vitoska26/agrotech_project/Extras/Project Sketch.pdf

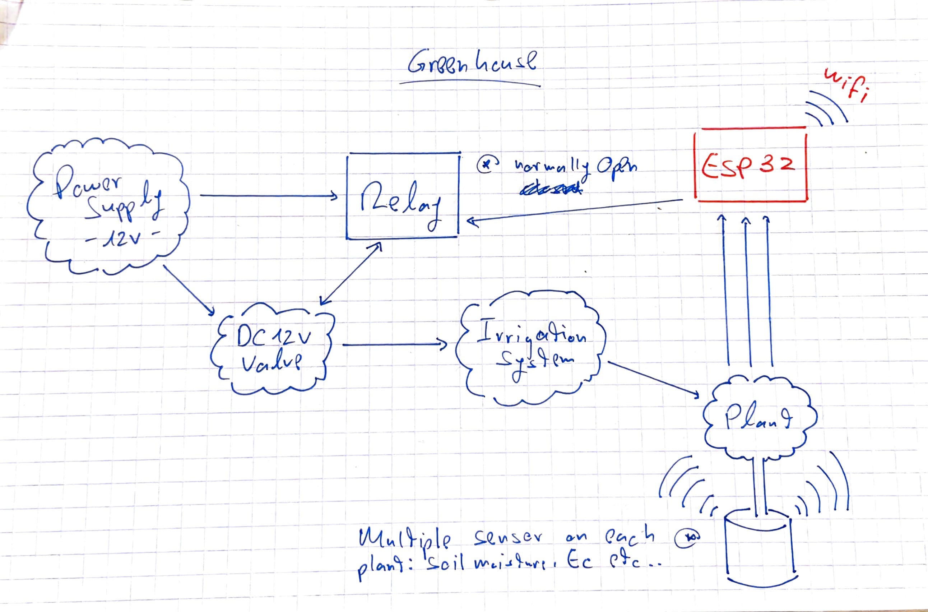
[picture p4: page 1]
