vitoska26/agrotech_project/Images/#1 Pepper.jpeg

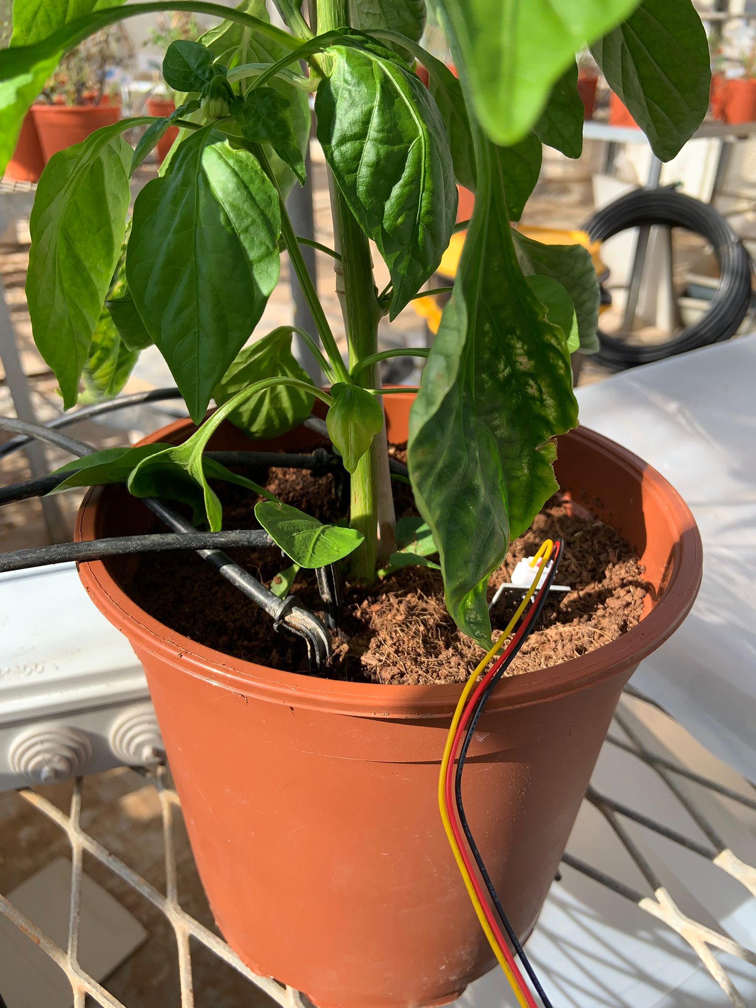
Images/#1 Pepper.jpeg
