vitoska26/agrotech_project/Images/#2 Pepper.jpeg

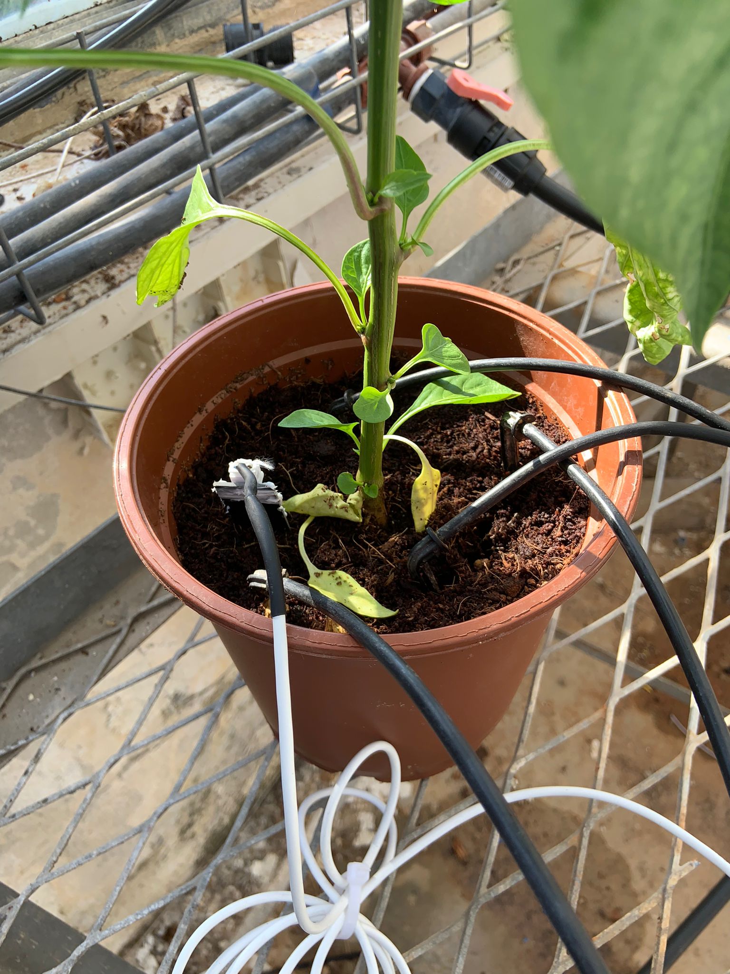
Images/#2 Pepper.jpeg
