vitoska26/agrotech_project/Images/basic circuit.jpeg

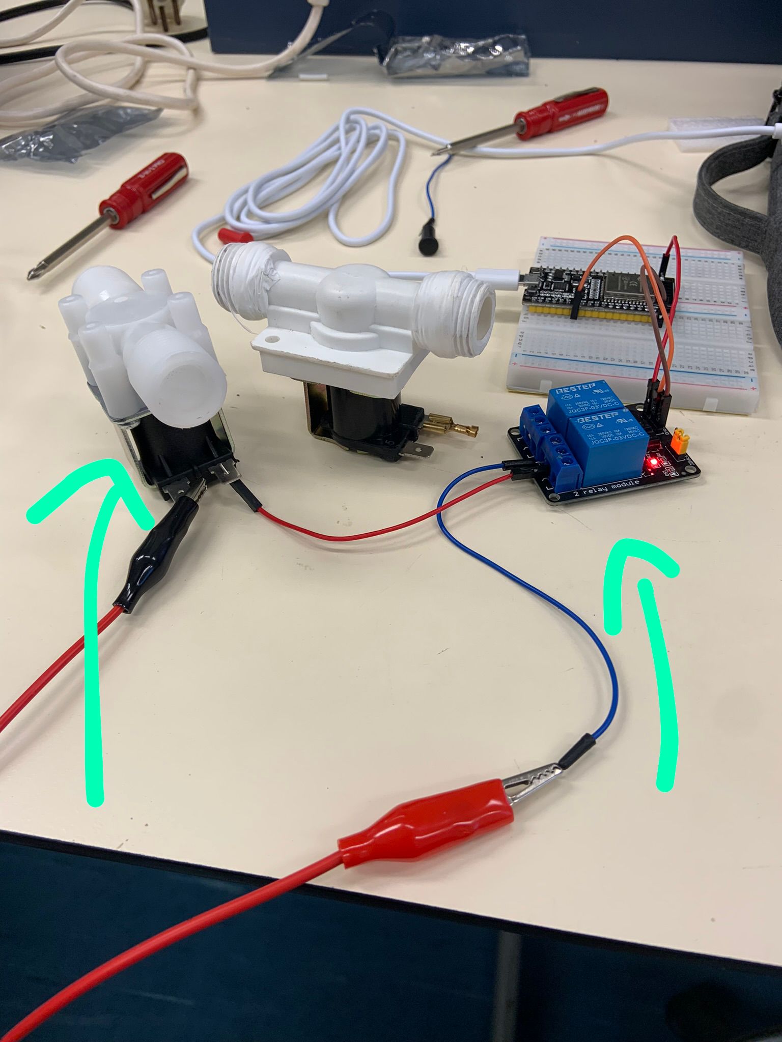
Images/basic circuit.jpeg
