vitoska26/agrotech_project/Images/Bird's Eye View.jpeg

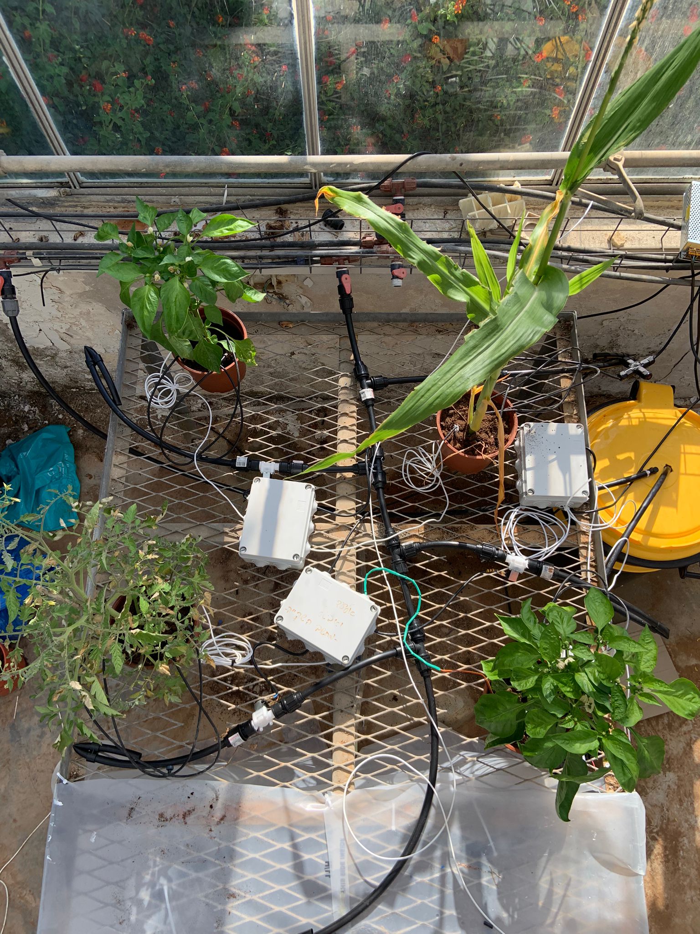
Images/Bird's Eye View.jpeg
