vitoska26/agrotech_project/Images/Corn Plant.jpeg

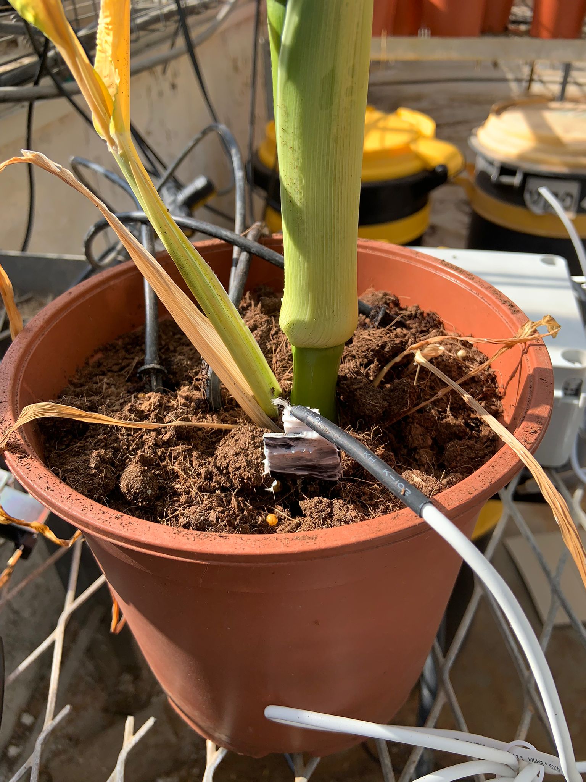
Images/Corn Plant.jpeg
