vitoska26/agrotech_project/Images/First prototype - 4 sensors 1 MCU.jpeg

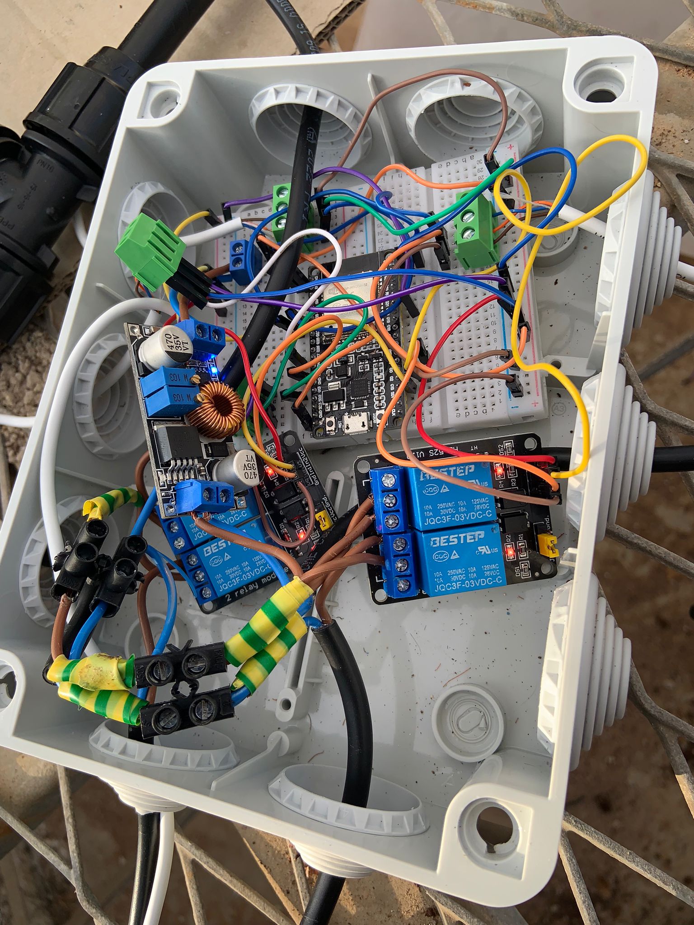
Images/First prototype - 4 sensors 1 MCU.jpeg
