vitoska26/agrotech_project/Images/first prototype.jpeg

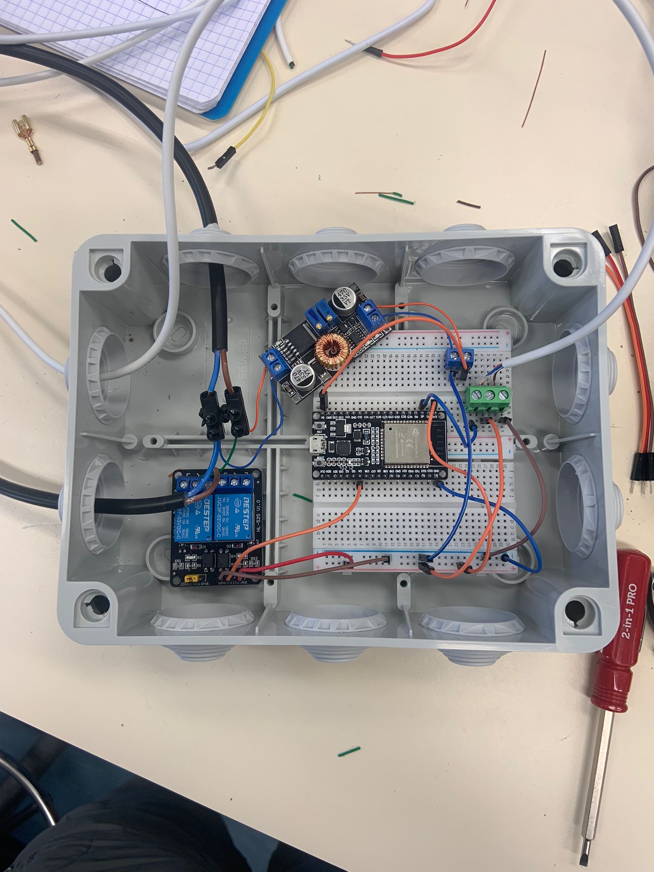
Images/first prototype.jpeg
