vitoska26/agrotech_project/Images/irrigation layout.jpeg

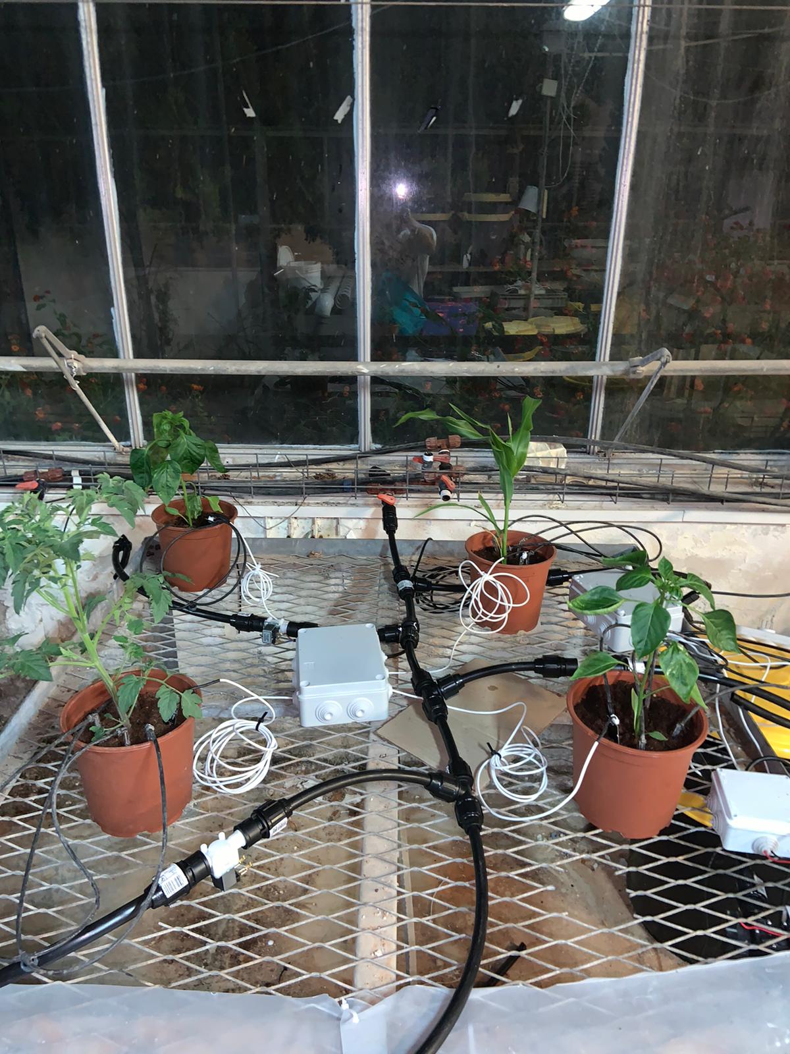
Images/irrigation layout.jpeg
