vitoska26/agrotech_project/Images/Tomato Plant.jpeg

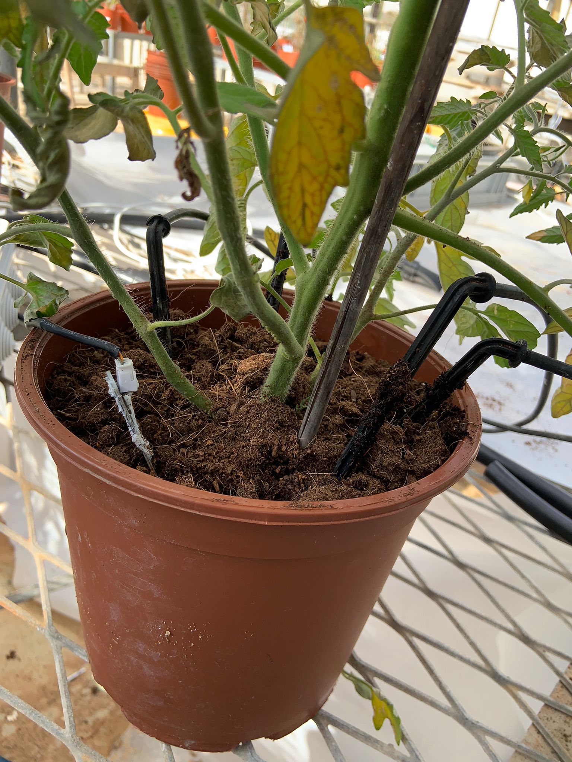
Images/Tomato Plant.jpeg
