vitoska26/agrotech_project/Code/Sensor_Controlled_Irrigation_System.ino

//------------------------------------------------------------------
//Thingspeak:
// #include <ESP8266WiFi.h>
#include <Arduino.h>
#include <WiFi.h>
#include <math.h>
#include <Adafruit_GFX.h>
#include "ThingSpeak.h"
#include "i2cArduino.h"

//RELAY PINS
#define RP2 2
#define RP15 15
//ThingSpeak Consts
unsigned long myChannelNumber = 1757836;
const char * myWriteAPIKey = "PRMQ9ELIDYEHYWPA";
//Greenhouse Wifi Consts
const char* ssid = "agrotech-lab-1";
const char* password="1Afuna2Gezer";


//soil moisture sensor consts - sensor with added 1M ohm resistor - BY PIN LAYOUT
const int dry35 = 2200;// value for dry sensor
const int wet35 = 550;
const int dry32 = 2100;// value for dry sensor
const int wet32 = 540;
const char* server = "api.thingspeak.com";

WiFiClient client;

#include <Wire.h>

//------------------------------------------------------------------

void setup() {
  // put your setup code here, to run once:
  Serial.begin(9600);
  Serial.println();
  Serial.print("Connecting to AP");
  WiFi.begin(ssid, password);
  while (WiFi.status() != WL_CONNECTED){
    Serial.print(".");
    delay(200);
  }
  Serial.println("");
  Serial.println("WiFi connected.");
  Serial.println("IP address: ");
  Serial.println(WiFi.localIP());
  Serial.println();
//--------------------------------------
//Thingspeak and wifi:
  WiFi.disconnect();
  delay(10);
  WiFi.begin(ssid, password);

  Serial.println();
  Serial.println();
  Serial.print("Connecting to ");
  Serial.println(ssid);

  ThingSpeak.begin(client);
 
  WiFi.begin(ssid, password);
  
 
  while (WiFi.status() != WL_CONNECTED) {
    delay(500);
    Serial.print(".");
  }
  Serial.println("");
  Serial.print("NodeMcu connected to wifi...");
  Serial.println(ssid);
  Serial.println();
  //------------------------------------------------------------------
  //relay setup
  pinMode(RP2,OUTPUT);
  pinMode(RP15,OUTPUT);

}

void loop() {
  // put your main code here, to run repeatedly:
  //soil sensors analog readings
  int sensorVal35 = analogRead(35);
  int sensorVal32 = analogRead(32);
  //SH - Soil Moisture (accidently named 'humidity')
  int SH35 = map(sensorVal35, wet35, dry35, 100, 0);//fixed function to convert analog readings into moisture % 
  Serial.print("Soil moisture in pepper plant is "); Serial.print(SH35);
  Serial.println("%");  
  delay(100);
  //same for 2nd sensor
  int SH32 = map(sensorVal32, wet32, dry32, 100, 0); 
  Serial.print("Soil moisture in tomato plant is "); Serial.print(SH32);
  Serial.println("%");  
  delay(100);

  //sensor35 - relay 15 control
  //tomato plant - suitable SM about 70-80%
  if (SH35<75){//if soil moisture 35 is below 75% *Data taken from the internet
    digitalWrite(RP15, LOW);//open the valve 
  }
  if (SH35>=75){//if soil moisture 35 is bigger then or equal to 75%
    digitalWrite(RP15, HIGH);//shut the valve off, or keep it shut
  }
  //sensor32 - relay 2 control
  //#1 pepper plant
  if (SH32<56){//if soil 32 moisture is below 56% *Data taken from the internet
    digitalWrite(RP2, LOW);//open the valve 
  }
  
  if (SH32>=56){//if soil moisture 32 is bigger then 56%
    digitalWrite(RP2, HIGH);//shut the valve off, or keep it shut
  }
  delay(1000);
//------------------------------------------------------------------------------------
  //Upload to Thingspeak:
  ThingSpeak.setField(1,SH35); // soil moisture 35
  ThingSpeak.setField(2,SH32); // soil moisture 32

  ThingSpeak.writeFields(myChannelNumber, myWriteAPIKey);
  Serial.println("uploaded to Thingspeak server....");
  
  client.stop();
  
  Serial.println("Waiting to upload next reading...");
  Serial.println();
  delay(1000);
  // thingspeak free needs minimum 15 sec delay between updates 
  
}
