vitoska26/agrotech_project/(commit log)

2022-07-14 Added prototype photo
2022-07-17 Rename Main/Extras to Code/Soil Sensor Calibrating
2022-07-17 Create Soil Sensor Calibrating
2022-07-17 Added data feeds csv files
    [feeds_other.csv]
